T-Lind/lightning-detector/hardware/reference/README.md

# Licensed board references

The two unmodified Eagle board files are used to check dimensions, mounting holes and electrical connections. Their original upstream licenses and README files are preserved. This project does not modify or manufacture either vendor PCB.

- **Adafruit Feather ESP32 V2**, designed by Limor Fried/Ladyada for Adafruit Industries: [repository](https://github.com/adafruit/Adafruit-ESP32-Feather-V2-PCB), commit `cbde2c6658acb3c788616ceb13423b5d36305ef0`; [original license](feather-license.txt), CC BY-SA 3.0.
- **SparkFun AS3935 Lightning Detector v20**: [repository](https://github.com/sparkfun/SparkFun_AS3935_Lightning_Detector), commit `e5c68988694d06dc4b19c65a573f02f4260eb706`; [original license](sensor-LICENSE.md), hardware CC BY-SA 4.0.

Manufacturer datasheets/drawings and enclosure CAD are linked in [sources](../../docs/sources.md), downloaded locally where needed, and not redistributed here. See [third-party notices](../../THIRD_PARTY.md).
