T-Lind/lightning-detector/firmware/data/README.txt

Initial empty event storage. Upload this only to a NEW device.
