T-Lind/lightning-detector/hardware/drawings/carrier-template-1to1.png

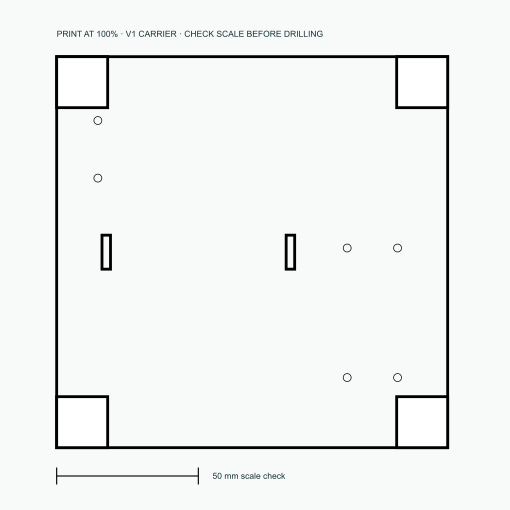
hardware/drawings/carrier-template-1to1.png
