T-Lind/lightning-detector/hardware/drawings/enclosure-layout.png

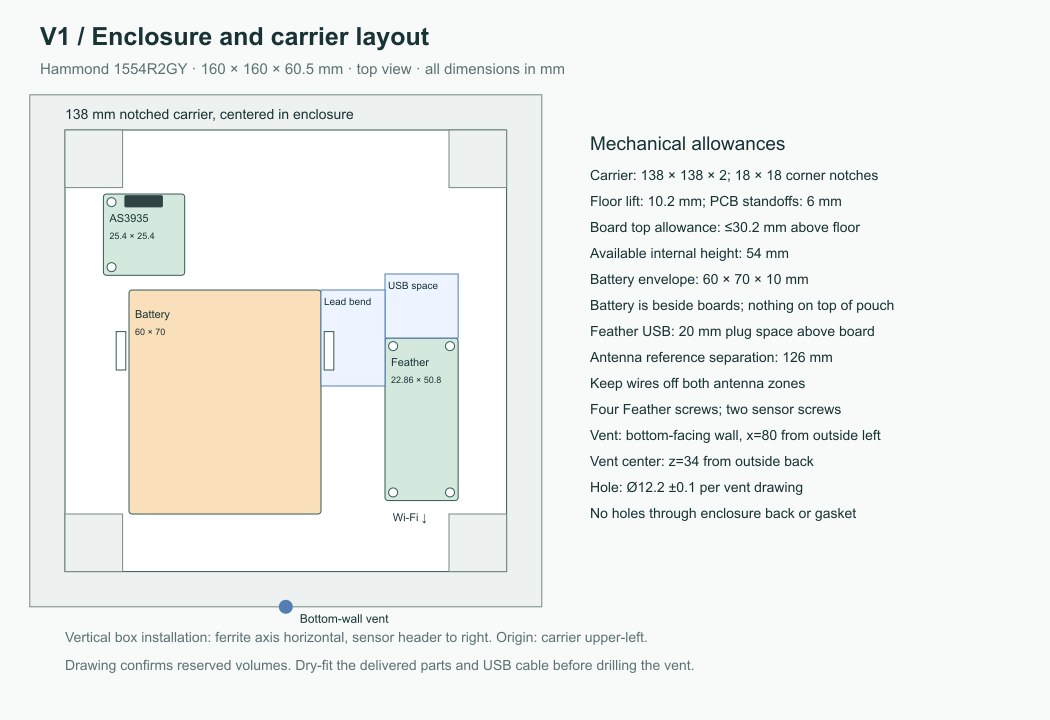
hardware/drawings/enclosure-layout.png
