T-Lind/lightning-detector/hardware/3d/carrier.step

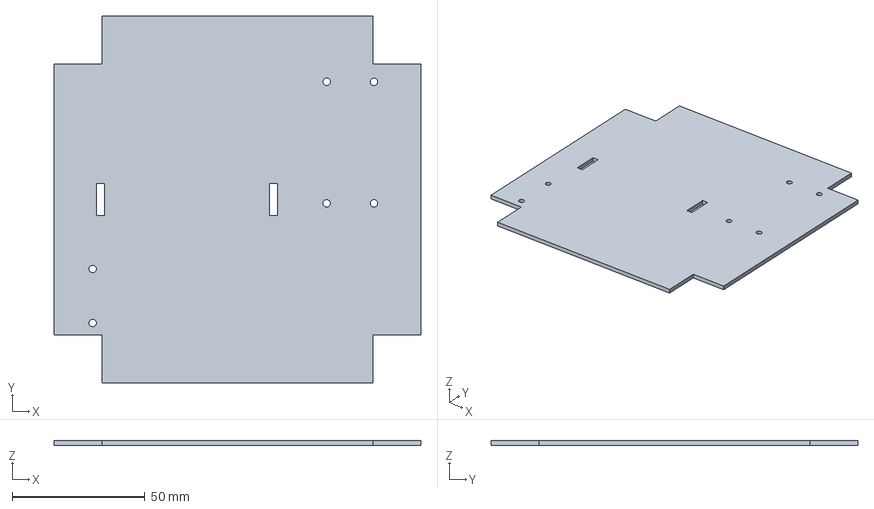
[picture p4: CAD file, 2026-10-10]
hardware/3d/carrier.step
138.0 x 138.0 x 2.00 mm
