T-Lind/lightning-detector/hardware/3d/floor-block.stl

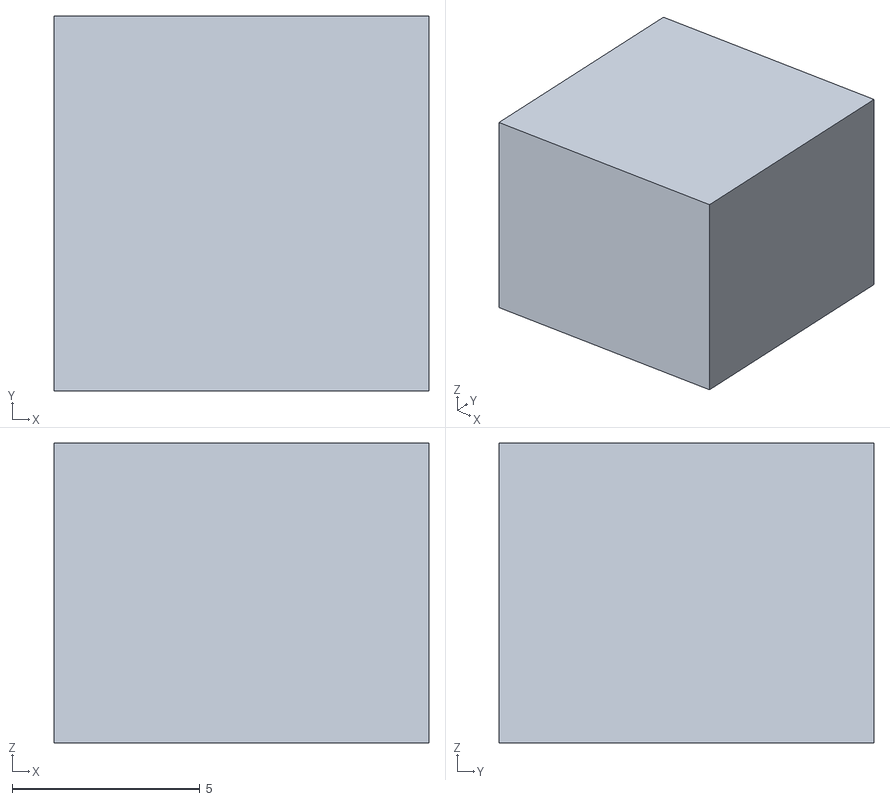
[picture p5: CAD file, 2026-10-10]
hardware/3d/floor-block.stl
10.0 x 10.0 x 8.00
