T-Lind/lightning-detector/(list of files, cad)

Other CAD files:
hardware/3d/carrier.stl
