T-Lind/lightning-detector/hardware/drawings/operation.png

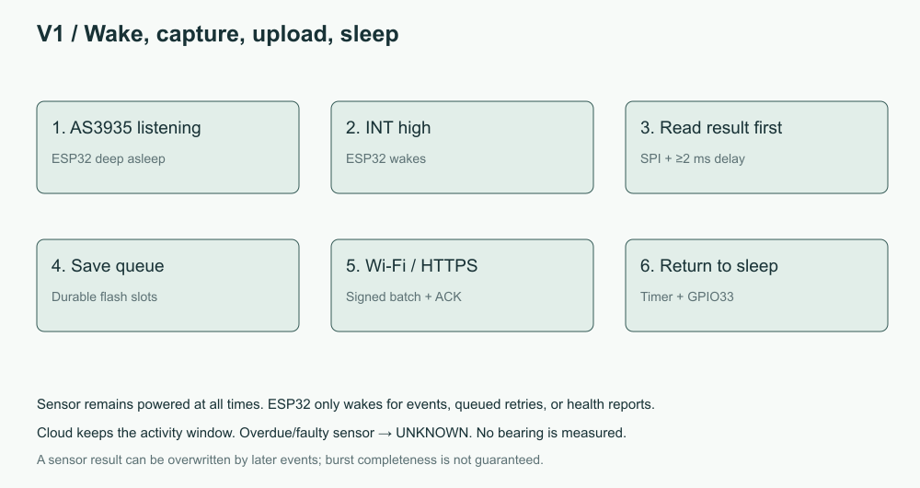
hardware/drawings/operation.png
