T-Lind/lightning-detector/firmware/include/tls_ca.example.h

#pragma once
// Run tools/install_ca.py with a PEM root for your deployed hostname.
// The firmware never uses setInsecure(). Do not use the example for deployment.
static const char TLS_CA_CERT[] = "";
