T-Lind/lightning-detector/(commit log)

2026-10-10 Publish reproducible lightning detector source and build guides
    [bom.csv, carrier.scad, carrier.step, carrier.stl, feather-Adafruit ESP32 Feather V2.brd, floor-block.stl, partitions.csv, sensor-SparkFun_AS3935_Lightning_Detector.brd]
2026-10-10 Normalize generic BOM CSV line endings
    [bom.csv]
2026-10-11 Document low power sensor expansion options
2026-10-21 Separate sensor diagnostics from lightning activity and prepare interrupt fixes
    [config.h, interrupt_reason.h, main.cpp]
